dome-94/smart-weather-station-iot/docs/links.md

# 🔗 Project Media & External Resources

This document contains external cloud resources, presentation slides, and demonstration video links for the **Smart Weather Station IoT (IOT102 Final Project)**.

---

## 🎥 Video Demonstration
- **Demonstration Video (Google Drive)**: [Watch System Demo Video](https://drive.google.com/file/d/11cMH0WwSyZTcYttvgiP_zKkVfedbLLi1/view?usp=sharing)
- **Scope**: Demonstrates end-to-end hardware sensor telemetry over LoRa P2P 433MHz, ESP8266 Gateway dual-mode WiFi/Captive Portal, ThingSpeak IoT cloud synchronization, automated Python ML weather forecasting via GitHub Actions, and real-time Web Dashboard alerts.

---

## 📑 Presentation Slides & Academic Audit Records
- **Course Artifacts Folder (Google Drive)**: [Open Presentation & Audit Log Folder](https://drive.google.com/drive/folders/1S3p0Ww-17E4YuMg9cDz8nPTEcB69zPZF?usp=sharing)
- **Included Materials**:
  - Final Presentation Slides (`.pptx` / `.pdf`)
  - AI Usage Audit Logs & Academic Integrity Records
  - High-resolution hardware schematics and photos

---

## 📄 Final Academic Report
- The full final report is available directly in this repository: [Report_Group1_SE2036_SU26.pdf](Report_Group1_SE2036_SU26.pdf)
- Member Contribution breakdown: [Contribution.docx](Contribution.docx)
