dome-94/smart-weather-station-iot/docs/ai_audit_logs/Group1_AI_Auditlog_BangDCE205075.xlsx

Sheet: 1. Metadata & Summary
AI AUDIT LOG - METADATA & SUMMARY
STUDENT INFORMATION
Student Name: |  | Đào Chí Bằng
Student ID: |  | SE205075
Course: |  | IOT102
Assignment: |  | LoRa-Based Weather Station Monitoring System
AI USAGE SUMMARY
Total Prompts Used (all AI tools): |  | 50
Core Prompts Logged: |  | 8
Selection Ratio: |  | 16.0% |  | Should be 10-20%
Hallucination Detected: |  | [Count]
AI TOOLS USED
AI Tool | Purpose | Frequency | Main Value
Google Gemini | Assisting with baseline microcontroller programming, configuring hardware module communications, and optimizing IoT device performance. | High | Rapidly providing code templates for component control, debugging hardware connection issues, and suggesting power-saving solutions.
OpenAI ChatGPT | Researching wireless network architecture overview, designing data transmission payloads, and structuring the technical report outline. | High | Defining the optimal connectivity model for the system, standardizing data formats, and organizing documentation scientifically.
CORE PROMPTS DISTRIBUTION BY DTC COMPONENT
DTC Component | Number of Prompts | Required (Min)
Decomposition | 3 | ≥ 1
Pattern Recognition | 3 | ≥ 1
Abstraction | 3 | ≥ 1
Algorithms | 3 | ≥ 1

Sheet: 2. Detailed Audit Log
DETAILED AI AUDIT LOG
INSTRUCTIONS: Chỉ ghi CORE PROMPTS (Decision/Problem-Solving/Verification). Mỗi entry phải trả lời đầy đủ 4 câu hỏi trong Human Delta.
Entry # | Category | Stage/Component | Problem/Context | Prompt to AI | AI Response (Summary) | Human Delta & Reflection | Evidence
001 | Literature Review | System Architecture | The project requires a clear understanding of how a LoRa-based weather station monitoring system is typically designed. Before selecting hardware and software components, it was necessary to investigate common architectures used in academic and industrial implementations. | Explain the architecture of a LoRa-based weather station monitoring system and describe the role of sensors, ESP32, LoRa communication modules, gateways, cloud services, and monitoring dashboards. | The AI described a multi-layer architecture consisting of environmental sensors collecting weather data, ESP32 acting as the local controller, LoRa modules transmitting data over long distances, a gateway receiving packets, and cloud platforms visualizing information through dashboards. | The response provided a useful overview but remained generic. I reviewed several research papers and noticed that some implementations used LoRaWAN gateways while others used direct LoRa communication. Because the project scope is limited to a university prototype, implementing a complete LoRaWAN infrastructure would increase complexity without providing significant benefits. I therefore adapted the architecture by using direct LoRa communication between nodes and the receiver. The AI recommendation served as a starting point, but the final design decision was based on project constraints, budget considerations, and implementation feasibility. | Research papers, LoRa documentation, and project architecture diagram.
002 | Technology Comparison | Hardware Selection | The project required selecting a suitable microcontroller platform capable of handling sensor data acquisition, wireless communication, and future scalability. | Compare ESP32, ESP8266, and Arduino Uno for a LoRa-based weather monitoring project. Include processing power, memory, connectivity, and development flexibility. | The AI compared the three platforms and highlighted that ESP32 offers higher processing capability, integrated Wi-Fi and Bluetooth, larger memory, and better support for IoT applications. | The AI's comparison was generally accurate, but I validated the specifications using official datasheets. Arduino Uno was eliminated because of limited memory and processing capability. ESP8266 was considered a possible alternative, but its reduced resources could create limitations when integrating additional features in future versions. ESP32 offered a better balance between performance and cost. After considering development flexibility and long-term scalability, I selected ESP32 as the primary controller. This decision was supported by both AI recommendations and technical documentation. | ESP32 datasheet, ESP8266 datasheet, Arduino Uno specifications.
003 | Communication Design | Network Communication | One of the most important decisions was determining whether LoRa or Wi-Fi should be used as the primary communication technology for environmental monitoring. | Compare LoRa and Wi-Fi for outdoor weather monitoring systems, focusing on communication range, power consumption, reliability, and deployment cost. | The AI explained that LoRa provides long-distance communication and lower power consumption, while Wi-Fi offers higher bandwidth but shorter coverage and greater energy usage. | The response aligned with my initial understanding but required verification. I compared the AI explanation with technical resources from LoRa Alliance and academic publications. The analysis confirmed that LoRa is more suitable for remote monitoring environments where communication distance is a major concern. Although Wi-Fi would simplify cloud integration, it would significantly reduce deployment flexibility in outdoor environments. Consequently, LoRa was selected as the primary communication method, while Wi-Fi was retained only for local dashboard access and testing purposes. This hybrid approach balanced reliability and accessibility. | LoRa Alliance documentation and related IoT communication studies.
004 | Dashboard Selection | Cloud & Visualization | The project needed a dashboard solution capable of displaying real-time weather information and historical trends. | Compare Blynk and ThingSpeak for weather station monitoring projects. Discuss visualization features, ease of setup, analytics, and educational use. | The AI explained that Blynk focuses on user-friendly mobile dashboards and real-time visualization, whereas ThingSpeak emphasizes data analytics and cloud-based processing. | The AI comparison was useful but lacked practical deployment considerations. I tested both platforms using sample sensor data. Blynk provided a more attractive interface and faster setup process, making it suitable for project demonstrations. ThingSpeak offered stronger analytical features but required additional configuration. Since the primary objective of this project is monitoring rather than advanced analytics, I selected Blynk as the main dashboard platform. This decision improved usability while still satisfying the project requirements. | Blynk documentation, ThingSpeak documentation, prototype testing results.
005 | Fault Tolerance | System Reliability | The system should continue providing monitoring capabilities even when Internet connectivity becomes unavailable. | Suggest methods to maintain weather monitoring functionality during Internet outages in an ESP32 and LoRa-based system. | The AI recommended implementing local storage, buffering sensor data, and hosting a local web server on ESP32. | The recommendations were practical and directly relevant to the project. However, implementing all suggested features would exceed available development time. After evaluating complexity and benefits, I prioritized the Local Web Server approach because it allows users to access weather information directly within the local network. Data buffering was also considered for future improvements. The final design therefore includes offline visualization through a local web interface while maintaining cloud synchronization whenever connectivity is restored. | ESP32 Web Server implementation and project testing logs.
006 | Power Optimization | Energy Management | Weather stations are often deployed in remote areas where power efficiency is important. | How can ESP32 power consumption be minimized in a remote weather monitoring application? | The AI recommended Deep Sleep Mode, reduced transmission frequency, optimized sensor polling intervals, and disabling unused peripherals. | The response introduced several useful strategies. I further reviewed ESP32 power management documentation to understand implementation details. Deep Sleep Mode was identified as the most impactful optimization because the system only needs to collect data periodically rather than continuously. I modified the data collection cycle to wake the controller, gather measurements, transmit data, and return to sleep mode. This significantly reduced estimated power consumption and improved the feasibility of battery-powered operation. | ESP32 Power Management Documentation and prototype measurements.
007 | Cloud Integration | Gateway Node – ThingSpeak Cloud Storage | The existing weather station system only displayed real-time sensor data through the ESP8266 Local Web Server. No historical data was stored, making it difficult to analyze weather trends over long periods or generate charts for project reports. | How can I integrate ThingSpeak into the ESP8266 Gateway so that weather data received from LoRa can be stored in the cloud and visualized using historical charts? | The AI suggested creating a ThingSpeak channel, using the ESP8266 HTTPClient library, and sending temperature, humidity, pressure, and rain sensor data through HTTP requests. It also recommended mapping each sensor value to a ThingSpeak field for automatic storage and chart generation. | The AI provided a suitable approach for cloud integration but did not fully consider the current Gateway architecture. After reviewing the recommendation, I identified the need for Internet connectivity in addition to the existing Local Web Server. I adapted the implementation to support cloud synchronization while preserving local monitoring functions. I also added upload interval control and transmission error checking to ensure stable operation and compliance with ThingSpeak limitations. This enhancement allows long-term weather data storage and supports report preparation through automatically generated historical charts. | ThingSpeak channel configuration, ESP8266 HTTPClient implementation, modified Gateway source code, successful data uploads, and historical weather charts generated on the ThingSpeak platform.
008 | Frontend Development | Weather Dashboard UI/UX | The weather station project required a user-friendly dashboard for displaying real-time weather information received from the Gateway Node. The initial interface only showed raw values and lacked visual organization, making it difficult for users to quickly understand environmental conditions. | Create a modern HTML/CSS/JavaScript dashboard for an ESP8266 Local Web Server that displays temperature, humidity, pressure, rain status, system status, and a weather chart using a responsive design. | The AI generated a responsive weather dashboard using HTML, CSS, and JavaScript. The design included information cards, a large temperature display, status indicators, weather icons, and a Chart.js graph for visualizing temperature trends. The dashboard also used JavaScript fetch requests to retrieve real-time sensor data from the ESP8266 JSON API. | The AI-generated dashboard provided a good foundation but required optimization before deployment on the ESP8266 Local Web Server. I modified the layout, adjusted styling for better readability, integrated the existing JSON API structure, and ensured that weather data updated automatically without refreshing the page. Additional status indicators and chart visualization features were added to improve usability and presentation quality. The final dashboard achieved a professional appearance while remaining lightweight enough for embedded system deployment. | Dashboard HTML source code, CSS styling, JavaScript fetch implementation, real-time weather data display, Chart.js integration, and successful deployment on the ESP8266 Local Web Server.
009 | Firmware Logic Verification | ESP32 Sensor Node Workflow | The firmware workflow became more complex after integrating multiple sensors, LoRa communication, ACK verification, and Deep Sleep mode. Before final implementation, the team needed to verify that the execution sequence was logically correct and consistent with the system design. | Explain the execution workflow of an ESP32-based LoRa weather station firmware, including sensor initialization, data acquisition, packet transmission, ACK verification, retransmission, and Deep Sleep operation. | The AI described a complete firmware execution process beginning with system initialization, sensor reading, LoRa packet transmission, acknowledgment handling, and power-saving through Deep Sleep Mode. | The explanation was helpful for understanding the overall workflow, but several implementation details were incomplete. The AI omitted the retry limit, RTC memory update, and CRC verification sequence used in our project. I compared the explanation with the actual firmware and modified the workflow to accurately represent the implemented logic. The final flowchart was validated during system testing and included in the project documentation. | Firmware source code, system flowchart, implementation notes.
010 | System Testing | System Validation | Before the final demonstration, the complete weather monitoring system had to be validated to ensure reliable communication between sensors, LoRa nodes, the gateway, cloud services, and the dashboard. | Generate a testing checklist for a LoRa-based weather monitoring system, including sensor accuracy, wireless communication, cloud synchronization, dashboard visualization, and power management. | The AI generated a structured testing checklist covering hardware functionality, communication reliability, cloud connectivity, visualization accuracy, and system stability. | The generated checklist provided a useful starting point but did not include several project-specific scenarios such as LoRa retransmission testing, Deep Sleep recovery, and offline Local Web Server operation. I expanded the checklist based on actual testing activities performed during system validation to ensure all implemented features were verified before deployment. | System testing report, validation checklist, demonstration results.
011 | Presentation & Documentation | Technical Documentation | The project presentation required concise technical explanations describing the overall system architecture, firmware workflow, and communication process for the final demonstration. | Summarize the workflow of the LoRa weather monitoring system for presentation slides using concise and technically accurate language. | The AI produced a clear summary describing sensor data collection, LoRa communication, gateway processing, cloud synchronization, and dashboard visualization. | Although the explanation was well organized, it omitted several implementation details such as ACK validation, retransmission control, and offline monitoring through the Local Web Server. I revised the content using the actual firmware implementation and project architecture before including it in the presentation slides. | Final presentation slides, project documentation.
012 | Performance Optimization | Firmware Optimization | As the firmware became more complex with multiple sensors, LoRa communication, cloud synchronization, and power management, the team needed to improve system performance while maintaining reliability and reducing energy consumption. | Suggest optimization techniques for an ESP32-based LoRa weather monitoring system to improve performance, reduce memory usage, and minimize power consumption without affecting communication reliability. | The AI recommended optimizing sensor reading intervals, reducing unnecessary memory allocation, using Deep Sleep mode effectively, minimizing redundant data transmission, and improving code modularity for better maintainability. | Most recommendations were useful, but some optimization suggestions were not suitable for our implementation because they could reduce communication reliability. The team selectively applied appropriate improvements, including optimizing code structure, reducing unnecessary processing, and maintaining the existing ACK verification and retransmission mechanisms. The final firmware achieved better performance while preserving stable system operation. | Optimized firmware source code, testing results, power consumption comparison.

Sheet: 3. Hallucination Detection
HALLUCINATION DETECTION LOG (BẮT BUỘC)
MỖI PROJECT PHẢI PHÁT HIỆN ÍT NHẤT: Lab (≥1), Assignment (≥2), Project (≥3) cases hallucination
Entry # (from Sheet 2) | Hallucination Type | AI's Claim | Actual Fact | Detection Method | Correction Applied
001 | Technical Error | AI stated that ThingSpeak provides built-in real-time push notifications by default. | ThingSpeak primarily focuses on data collection, storage, visualization, and analytics. It does not provide native real-time push notification functionality in the same way as dedicated IoT dashboard platforms. | Verified the claim by reviewing the official ThingSpeak documentation and platform feature descriptions. | Removed the incorrect statement from the report and updated the platform comparison section to accurately describe ThingSpeak's capabilities.
002 | Incorrect Assumption | AI suggested that all ESP32 development boards include integrated LoRa communication modules. | Only specific ESP32 variants, such as ESP32 LoRa development boards, include built-in LoRa hardware. Standard ESP32 boards require an external LoRa module. | Verified hardware specifications using manufacturer datasheets and product documentation. | Revised the hardware selection section and clarified the distinction between standard ESP32 boards and LoRa-enabled variants.
003 | Sensor Misclassification | AI described the DHT22 sensor as a soil moisture sensor. | The DHT22 sensor is designed to measure ambient temperature and relative humidity. It cannot measure soil moisture levels. | Compared AI statement with LoRaWAN documentation and published experimental studies. | Updated the sensor description and corrected all references to sensor functionality within the project documentation.
004 | Overgeneralization | AI stated that all LoRa weather monitoring systems use cloud platforms such as ThingSpeak for data storage. | LoRa and Wi-Fi are designed for different purposes. LoRa offers long-range communication with low power consumption, while Wi-Fi provides higher bandwidth and faster data transmission. | Compared technical specifications, deployment scenarios, and performance characteristics from official documentation. | Added a balanced discussion explaining the strengths, limitations, and appropriate use cases of both technologies within the project report.
005 | Implementation Assumption | The generated dashboard code can be directly deployed to the ESP8266 Local Web Server without modification. | The generated code required adjustments to match the existing Gateway JSON API and optimize performance for the ESP8266 environment. | Reviewed the generated HTML/CSS/JavaScript code and tested it with the Gateway firmware. Several API endpoints and variable mappings were incompatible with the actual implementation. | Modified the JavaScript fetch requests, updated variable names according to the Gateway JSON structure, and optimized the dashboard to ensure stable operation on ESP8266.
006 | Context Ignorance | ThingSpeak integration can be added directly to the existing Gateway architecture without additional network configuration. | The existing Gateway was designed primarily as a Local Web Server using Wi-Fi Access Point mode. Internet connectivity and upload rate control were required before ThingSpeak integration could function correctly. | Compared the AI recommendation with the current Gateway firmware architecture and tested cloud communication requirements against ThingSpeak documentation. | Added Internet connectivity support, implemented upload interval control to comply with ThingSpeak limitations, and included error handling for failed data transmissions.
007 | Configuration Error | AI suggested that the ESP32 could upload sensor data directly to ThingSpeak without considering the gateway configuration or network architecture. | In our project, sensor data is transmitted via LoRa to the gateway, which processes the data before sending it to ThingSpeak using the correct API key and network connection. | Compared the AI-generated solution with the implemented gateway architecture and tested the actual cloud data transmission. | Modified the data flow to match the implemented architecture and configured the correct API endpoint, channel ID, and Write API Key before deployment.
HALLUCINATION TYPES REFERENCE:
Type | Definition | Example
Fabrication | AI tạo ra thông tin không tồn tại | Fake papers, fake APIs, fake data
Oversimplification | AI bỏ qua edge cases, exceptions | Code không handle array rỗng
Logic Error | AI đưa kết luận sai về 'best practice' | 'XGBoost always best' → Sai
Outdated Info | AI dùng thông tin cũ, không còn đúng | Old API syntax, deprecated methods
Context Misunderstanding | AI không hiểu đúng bối cảnh | Không biết business constraints

Sheet: 4. Self-Assessment Checklist
SELF-ASSESSMENT CHECKLIST (Trước khi nộp)
Kiểm tra kỹ trước khi nộp. MỖI ENTRY phải pass ≥4/5 tiêu chí dưới đây.
A. KIỂM TRA CHẤT LƯỢNG MỖI ENTRY (Pass ≥4/5)
# | Tiêu chí | Pass? | Note
1 | Prompt này ảnh hưởng đến quyết định quan trọng trong project? | ✅ | Clearly clarified the role of the prompt in shaping the core modules and optimizing the research progress.
2 | Nếu không có prompt này, project có thay đổi về architecture/design? | ✅ | Helped define and standardize the system architecture, preventing initial errors in circuit and algorithm design.
3 | Tôi có thể giải thích lý do chọn/không chọn gợi ý của AI? | ✅ | Thoroughly cross-referenced with system theory, retaining optimal solutions and filtering out impractical proposals.
4 | Có minh chứng cụ thể (code, metrics, comparison)? | ✅ | Fully supported by block diagrams, technical specifications from datasheets, and actual measurement data to validate results.
5 | Prompt này phản ánh tư duy phản biện, không chỉ copy AI? | ✅ | Demonstrated a continuous process of questioning, cross-checking reference materials, and self-correcting AI hallucinations.
B. KIỂM TRA TỔNG THỂ LOG
# | Tiêu chí | Pass? | Current Value
1 | Số lượng entries nằm trong range (min-max)? | ✅ | 10 entries
2 | Mỗi DTC component có ít nhất 1 core prompt? | Q | Each DTC component has at least one corresponding core prompt.
3 | Đã phát hiện ≥ số lượng hallucination yêu cầu? | ✅ | Hallucinations identified, verified, and corrected with reliable evidence.
4 | Mỗi entry đều có Human Delta đầy đủ (4 câu hỏi)? | ✅ | All 10 entries include complete Oral Viva preparation: why the prompt was used, AI limitations, team verification, and an alternative approach.
5 | Có evidence cho ≥70% entries? | ✅ | The ratio of actual concrete evidence meets the requirements, fully prepared for verification and cross-checkiEvidence is provided for all 10 entries, including source code, documentation, screenshots, test logs, and project records.ng.
⚠️ LƯU Ý QUAN TRỌNG:
Nếu entry KHÔNG pass ≥4/5 tiêu chí → LOẠI BỎ, không ghi vào Log
Nếu FAIL ≥2 tiêu chí tổng thể → AI Reflection = 0 điểm (mất 30%)
C. CHUẨN BỊ CHO ORAL VIVAS (Q&A)
Giảng viên sẽ hỏi ngẫu nhiên về 3-5 entries. Tự hỏi bản thân:
Entry # | Tôi có thể giải thích tại sao chọn approach này? | Tôi có nhớ AI response? | Tôi có evidence?
1 | Yes. I designed the Sensor Node flowchart to clearly describe the firmware execution from boot to Deep Sleep. | Yes. AI helped organize the workflow logically. | Yes. Final flowchart and project documentation.
2 | Yes. I included RTC memory, sensor validation, and Deep Sleep to improve reliability and power efficiency. | Yes. AI explained the ESP8266 execution flow. | Yes. Flowchart and firmware implementation.
3 | Yes. I added ACK verification, CRC-16 checking, and retry logic to improve LoRa communication reliability. | Yes. AI explained reliable communication concepts. | Yes. Flowchart, firmware logic, and communication tests.
4 | Yes. I Yes. I designed a responsive Local Dashboard to display weather information clearly on different devices.integrated ThingSpeak to store historical weather data and generate charts for long-term monitoring and reporting. | Yes. AI suggested the dashboard layout and UI improvements. | Yes. ThYes. HTML/CSS/JS source code and dashboard screenshots.ingSpeak configuration, upload logs, and generated historical charts.
5 | Yes. I used Chart.js and JSON APIs to visualize real-time weather data. | Yes. AI explained Chart.js and JavaScript fetch(). | Yes. Dashboard source code and testing results.
6 | Yes. I integrated the ESP8266 Local Web Server to provide real-time monitoring through Wi-Fi. | Yes. AI suggested the Web Server implementation. | Yes. ESP8266 source code and successful demonstrations.
7 | Yes. I integrated ThingSpeak to store historical weather data and generate cloud-based charts. | Yes. AI explained ThingSpeak API integration | Yes. ThingSpeak configuration, upload logs, and charts.
8 | Yes. I prepared the presentation slides to explain the system architecture, workflow, and implementation clearly. | Yes. AI suggested slide structure and content refinement. | Yes. Final presentation slides and project report.
9 | Yes. I prepared Oral Viva Q&A to explain design decisions, AI usage, limitations, and alternative solutions. | Yes. AI suggested possible Viva questions. | Yes. Oral Viva Q&A document and presentation notes.
10 | Yes. I reviewed and verified every AI-generated suggestion before applying it to the project. | Yes. AI was used only as a supporting tool; all outputs were manually verified. | Yes. AI Audit Log, code revisions, testing records, and project documents.
