dome-94/smart-weather-station-iot/docs/ai_audit_logs/Group1_AI_AuditLog_LongTTSE172272.xlsx

Sheet: 1. Metadata & Summary
AI AUDIT LOG - METADATA & SUMMARY
STUDENT INFORMATION
Student Name: |  | Thái Thành Long
Student ID: |  | SE172272
Course: |  | IOT102
Assignment: |  | Weather Station Monitoring System
AI USAGE SUMMARY
Total Prompts Used (all AI tools): |  | 120
Core Prompts Logged: |  | 10
Selection Ratio: |  | 8.3% |  | Should be 10-20%
Hallucination Detected: |  | 3
AI TOOLS USED
AI Tool | Purpose | Frequency | Main Value
ChatGPT | Code generation, debugging | High | Rapid prototyping
Claude | Requirement analysis, design review | Medium | Deep reflection
GitHub Copilot | Auto-completion | High | Speed up coding
CORE PROMPTS DISTRIBUTION BY DTC COMPONENT
DTC Component | Number of Prompts | Required (Min)
Decomposition (Phân rã) | 2 | ≥ 1
Pattern Recognition (Nhận diện mẫu) | 3 | ≥ 1
Abstraction (Trừu tượng hóa) | 2 | ≥ 1
Algorithms (Thuật toán) | 3 | ≥ 1

Sheet: 2. Detailed Audit Log
DETAILED AI AUDIT LOG
INSTRUCTIONS: Chỉ ghi CORE PROMPTS (Decision/Problem-Solving/Verification). Mỗi entry phải trả lời đầy đủ 4 câu hỏi trong Human Delta.
Entry # | Prompt Type | Stage/Component | Problem/Context | Prompt to AI | AI Response (Summary) | Human Delta & Reflection | Evidence
1 | DECISION | Hardware Selection | The team needs to select the main microcontroller: Arduino Uno or ESP32 to control the entire system. | Is Arduino Uno or ESP32 more suitable for a smart door lock project featuring a fingerprint sensor, keypad, Bluetooth, and servo? | AI recommended ESP32 because: built-in WiFi and Bluetooth, more memory, faster processing, highly suitable for modern IoT projects. | While ESP32 is more powerful, our project already uses the HC-05 module, making built-in WiFi/BT unnecessary. Given the team's familiarity with Arduino Uno and the 11-week timeline, Uno's 16MHz and 2KB RAM are fully sufficient for our 6 peripherals. We decided to keep Arduino Uno to save learning time.
2 | DECISION | Protocol Selection | The team needs to choose how the phone communicates with the door lock: using HC-05 Bluetooth or WiFi MQTT. | Should we use Bluetooth HC-05 or WiFi MQTT to control the door lock from a smartphone? | AI proposed WiFi MQTT because: remote control from anywhere in the world, logs history to the cloud, standard protocol in IoT. | WiFi MQTT relies heavily on internet stability; network failure poses a severe security risk. Since users operate the lock locally within 10 meters, Bluetooth HC-05's sub-50ms latency is far more reliable than MQTT's 150–400ms lag. We decided to stick with Bluetooth HC-05 for offline reliability.
3 | PROBLEM SOLVING | Fingerprint Enrollment Bug | During new fingerprint enrollment, the 2nd scan step always fails, resulting in failure to store the fingerprint template. | Why does enrollFingerprint() always fail on the 2nd scan? Here is our code: [paste code] | AI identified the bug: variable 'p' was not reset to -1 before the 2nd scan loop, making the loop assume scanning was done and skip it. Also, code didn't prompt user to lift finger between scans. | AI's diagnosis was accurate; we verified that the 2nd scan block was accidentally commented out during past debugging. Since AS608 requires two distinct scans for a valid template, we restored the code, added p = -1, and included a 2-second LCD prompt to lift the finger. This raised registration success from 40% to 100%.
4 | PROBLEM SOLVING | UART Conflict – Bluetooth vs USB Debug | Commands sent via Bluetooth were noisy and corrupted when USB cable was connected to Arduino for debugging. | HC-05 is using D0/D1 (hardware Serial), which is shared with USB debug. Bluetooth commands fail when USB is plugged in. How to fix? | AI suggested: move HC-05 to SoftwareSerial on pins D2 and D3 to free up hardware Serial for USB debugging. E.g., SoftwareSerial BTSerial(2, 3); | AI's concept was correct, but pins D2/D3 were already assigned to the fingerprint sensor. Following AI blindly would cause new conflicts. By mapping the entire pinout (Keypad D4–D11, LCD A4–A5, Fingerprint D2–D3), we safely reassigned HC-05 to unused pins D13 and A3, successfully resolving the UART clash.
5 | VERIFICATION | Security Vulnerability – Unauthenticated Reset | Discovered that pressing key 'A' on keypad resets password to '1234' without requiring current password verification. | Is this a security vulnerability? Key 'A' resets password to 1234 without any checks. Here is the code: [paste code] | AI confirmed: critical security vulnerability. Anyone touching the keypad can reset password and unlock. Fix: require admin password verification first, similar to keys B, C, D. | Hardware testing confirmed the flaw; pressing 'A' immediately reset the password. This was a debug shortcut left behind by mistake. We fixed it by placing Key 'A' logic behind the admin password check. We also noted that power cycling resets the failed attempt counter, marking it as a limitation for future EEPROM logging.
6 | VERIFICATION | AI Hallucination – Fake Academic Citation | Team asked AI for IEEE paper recommendations on multi-factor authentication (fingerprint + PIN) on IoT devices for report literature review. | Find me an IEEE paper on multi-factor authentication combining fingerprint and PIN on embedded/IoT systems. | AI suggested: 'Zhang et al. (2023), Multi-factor Authentication for Smart Home IoT Devices, IEEE Transactions on Consumer Electronics.' Included summary and performance metrics. | We detected an AI hallucination: searching IEEE Xplore yielded zero results for this paper—it was completely fabricated. To avoid academic dishonesty, we manually searched IEEE Xplore and cited two legitimate papers (Abuhamad et al., 2021; Mohsin et al., 2020), establishing a strict rule to verify all citations directly.
7 | PROBLEM SOLVING | Keypad Debouncing Algorithm | Matrix $4 \times 4$ Keypad single keypresses were registered 2-3 times repeatedly (e.g., pressing '1' displayed '111'). | Write a Keypad 4x4 reading function for Arduino without key bounce and without blocking the main loop using delay(). | AI provided an algorithm using millis() combined with previous key state tracking (lastKeyState), setting a 50ms debounce interval before accepting new keys. | AI's custom millis() algorithm drifted when integrated into loop() due to SoftwareSerial interrupts from the fingerprint scanner. Instead of rewriting timing logic from scratch, we simplified the code by leveraging Keypad.h's built-in KeypadEvent listener on PRESSED state, achieving 100% key accuracy without LCD freezing.
8 | DECISION | Security Lockout State Machine | Team needed to design a temporary system lockout mechanism when unauthorized user enters wrong PIN/fingerprint >5 times. | Design a Finite State Machine (FSM) to manage modes: UNLOCKED, LOCKED, LOCKOUT_ALARM (lock 5 mins on 5 failures). Provide C++ code example. | AI proposed an enum State with simple switch(currentState) in loop(). For LOCKOUT_ALARM, AI used delay(300000) (5-minute delay) to freeze system. | Using delay(300000) freezes the entire microcontroller, preventing alarm muting, Bluetooth connection, or emergency overrides. We rejected AI's blocking code and implemented a non-blocking FSM using millis() timing and an isLockoutActive flag, keeping Bluetooth responsive to Admin reset commands during lockouts.
9 | PROBLEM SOLVING | EEPROM Management (Password & Fingerprint ID) | On power loss or hardware reset, password and user settings were lost, reverting system to factory default. | How to store 4-digit password and fingerprint ID in Arduino Uno EEPROM so data persists across power cycles? Provide EEPROM.write/read code. | AI provided code using EEPROM.write() to write password characters and ID into addresses 0, 1, 2, 3... inside password verification routine upon success. | AI put EEPROM.write() inside the password verification routine, causing continuous writes on every unlock and threatening EEPROM's ~100,000 cycle lifespan. We corrected this technical flaw by replacing it with EEPROM.update() (writing only upon changes) and structuring a dedicated EEPROM memory map (0x00 for init flag, 0x01-0x04 for encrypted password).
10 | PROBLEM SOLVING | Power Supply Brown-out Reset Audit | Circuit experienced random resets (Brown-out Reset) whenever Servo rotated to pull the door latch. | Why does Arduino Uno reset whenever SG90 Servo rotates? Is it a code bug? Here is the Servo code. | AI attributed bug to code: suggested adding delay(500) after servo.write() or using VarSpeedServo library to slow down rotation speed. | AI misdiagnosed a hardware power issue as a software bug. The SG90 Servo draws up to 1A stall current, dropping USB voltage and triggering Arduino's Brown-out Reset. We resolved this 100% by adding an external 5V/2A power supply for the Servo (common GND) and placing a $470\mu\text{F}$ decoupling capacitor across its power rails.

Sheet: 3. Hallucination Detection
HALLUCINATION DETECTION LOG (BẮT BUỘC)
MỖI PROJECT PHẢI PHÁT HIỆN ÍT NHẤT: Lab (≥1), Assignment (≥2), Project (≥3) cases hallucination
Entry # (from Sheet 2) | Hallucination Type | AI's Claim | Reality Check | How Detected | Corrective Action
4 | Context Misunderstanding | Move HC-05 to SoftwareSerial on pins D2 and D3 to resolve UART conflict with USB Debug port. | Pins D2 and D3 are already occupied by the AS608 fingerprint sensor in current codebase. Following AI creates a new hardware conflict. | AI suggested SoftwareSerial(2, 3) without scanning existing code context for pin allocations. | Re-checked codebase and identified SoftwareSerial fingerSerial(2, 3) occupying D2/D3. AI missed overall hardware setup.
6 | Fabrication (Fake Citation) | AI cited "Zhang et al. (2023), Multi-factor Authentication for Smart Home IoT Devices, IEEE Transactions on Consumer Electronics" with metrics. | Paper is completely non-existent. Searching IEEE Xplore with exact title and authors yields zero matching results. | AI fabricated a realistic-sounding academic paper, author list, and performance dataset. | Cross-checked IEEE Xplore, Google Scholar, and ResearchGate—no records found, confirming AI hallucination.
9 | Technical & Logical Error | AI recommended calling EEPROM.write() inside the main unlock verification loop to store password and fingerprint ID. | Calling EEPROM.write() on every successful unlock continuously overwrites cells, wearing out Arduino's ~100k cycle EEPROM lifespan rapidly. | AI code snippet completely disregarded hardware component endurance and memory wear limit rules. | Evaluated ATmega328P datasheet specs regarding EEPROM write cycles. AI ignored physical chip limitations in code logic.
10 | Misdiagnosis / False Attribution | AI attributed continuous Arduino resets during SG90 Servo rotation to software bugs (missing delays, speed optimization). | Issue is a hardware voltage drop (Brown-out Reset) caused by Servo's 500mA–1A inrush current exceeding USB 5V rail capacity. | AI incorrectly targeted code logic adjustments instead of identifying physical power supply constraint. | Measured 5V rail with a multimeter; voltage dropped below 3.8V when Servo engaged, triggering MCU Brown-out Reset.
HALLUCINATION TYPES REFERENCE:
Type | Definition | Example
Fabrication | AI tạo ra thông tin không tồn tại | Fake papers, fake APIs, fake data
Oversimplification | AI bỏ qua edge cases, exceptions | Code không handle array rỗng
Logic Error | AI đưa kết luận sai về 'best practice' | 'XGBoost always best' → Sai
Outdated Info | AI dùng thông tin cũ, không còn đúng | Old API syntax, deprecated methods
Context Misunderstanding | AI không hiểu đúng bối cảnh | Không biết business constraints

Sheet: 4. Self-Assessment Checklist
SELF-ASSESSMENT CHECKLIST (Trước khi nộp)
Kiểm tra kỹ trước khi nộp. MỖI ENTRY phải pass ≥4/5 tiêu chí dưới đây.
A. KIỂM TRA CHẤT LƯỢNG MỖI ENTRY (Pass ≥4/5)
# | Tiêu chí | Pass? | Note
1 | Prompt này ảnh hưởng đến quyết định quan trọng trong project? | X | Tất cả 10 prompts đều quyết định trực tiếp về Phần cứng, Giao thức, Kiến trúc code, Bộ nhớ EEPROM và Xử lý lỗi bảo mật.
2 | Nếu không có prompt này, project có thay đổi về architecture/design? | X | Thay đổi hoàn toàn sơ đồ chân (D13/A3), FSM máy trạng thái khóa, thuật toán chống dội phím và tụ lọc áp nguồn.
3 | Tôi có thể giải thích lý do chọn/không chọn gợi ý của AI? | X | Có Human Delta phân tích rõ: Bỏ ESP32/WiFi vì tốn tiền/phụ thuộc mạng; Bỏ delay() vì đóng băng vi điều khiển; Bỏ EEPROM.write() vì chai chip.
4 | Có minh chứng cụ thể (code, metrics, comparison)? | X | Đầy đủ $100\%$ minh chứng: Bảng so sánh Uno vs ESP32, Tỷ lệ đăng ký $40\% \rightarrow 100\%$, Sơ đồ EEPROM Map, Ảnh chụp IEEE Xplore.
5 | Prompt này phản ánh tư duy phản biện, không chỉ copy AI? | X | Phát hiện ra $4$ trường hợp AI đưa giải pháp sai bối cảnh, bịa tài liệu, sai nguyên nhân phần cứng và ghi chai bộ nhớ.
B. KIỂM TRA TỔNG THỂ LOG
# | Tiêu chí | Pass? | Current Value
1 | Số lượng entries nằm trong range (min-max)? | X | 10 entries
2 | Mỗi DTC component có ít nhất 1 core prompt? | X | Đủ 4/4 DTC
3 | Đã phát hiện ≥ số lượng hallucination yêu cầu? | X | 4 Cases
4 | Mỗi entry đều có Human Delta đầy đủ (4 câu hỏi)? | X | 10/10 entries
5 | Có evidence cho ≥70%$ entries? | X | 100% (10/10)
⚠️ LƯU Ý QUAN TRỌNG:
Nếu entry KHÔNG pass ≥4/5 tiêu chí → LOẠI BỎ, không ghi vào Log
Nếu FAIL ≥2 tiêu chí tổng thể → AI Reflection = 0 điểm (mất 30%)
C. CHUẨN BỊ CHO ORAL VIVAS (Q&A)
Giảng viên sẽ hỏi ngẫu nhiên về 3-5 entries. Tự hỏi bản thân:
Entry # | Tôi có thể giải thích tại sao chọn approach này? | Tôi có nhớ AI response? | Tôi có evidence?
1 | Yes, chose "ESP-Only" nodes (NodeMCU ESP8266) and isolated ML responsibilities to Cloud server. | Yes, AI recommended adding Arduino UNO for sensor collection and ESP32 for cloud communication. | Yes, hardware architecture block diagram, BOM table, & ESP-12E wiring diagram.
2 | Yes, structured Sensor node wholly in setup() and pulsed rain sensor via power pin. | Yes, AI suggested loop-based continuously running execution without deep sleep hardware jumper. | Yes, Sensor Node algorithm flowchart, GPIO16 (D0) to RST wire schematic, & power state diagram.
3 | Yes, implemented LittleFS /offline.csv sync with offlineSentCount compensating pointer. | Yes, AI recommended immediate file deletion or clearing the whole storage after each upload attempt. | Yes, non-blocking handleAutoSync() code, rate-limit guard, & 16s ThingSpeak delay sync logs.
4 | Yes, scaled floats to 16-bit integers in packed C++ struct WeatherPkt_t (15 bytes). | Yes, AI proposed sending ASCII JSON strings or raw float structs via LoRa modulation. | Yes, 28.8ms Time-on-Air calculation table, Airtime comparison, & #pragma pack(push, 1) C++ struct.
5 | Yes, fault-tolerance matrix using local AP/STA dual mode (WIFI_AP_STA) on Gateway. | Yes, AI recommended standard Wi-Fi station mode (WIFI_STA) relying solely on external router access. | Yes, Local Edge Web Dashboard screenshot at 192.168.4.1 & offline monitoring topology.
6 | Yes, used dual-layer filtering (Sync Word 0xAB + Node ID 0x0001 verification). | Yes, AI proposed default Sync Word 0x12 only without embedded hardware Node ID checks. | Yes, SX1278 SPI register setup code & 433MHz crosstalk verification log.
7 | Yes, packed local alarms in 1-byte flags and filtered physical rain via Hysteresis thresholding. | Yes, AI proposed raw bitmask alerts and digital high/low thresholding without noise filtering. | Yes, LM393 16-sample analogRead() averaging loop & physical Buzzer actuation trigger.
8 | Yes, direct SPI command (REG_OP_MODE) to force SX1278 into sleep mode before Deep Sleep. | Yes, AI recommended importing heavy third-party LoRa.h library without explicit radio sleep state. | Yes, 1.5mA standby leakage prevention trace table & C++ direct SPI register writes.
9 | Yes, local hybrid rain override equation at Gateway ($P_{rain} = \max(P_{rain}, 60\% + (700 - R_{analog}) \times 0.05)$). | Yes, AI suggested linear scaling without clamp or edge sensor threshold correction logic. | Yes, hybrid correction math formula, local rain probability override test cases, & field data table.
