dome-94/smart-weather-station-iot/docs/ai_audit_logs/Group1_AI_AuditLog_ThinhHDSE200508.xlsx

Sheet: 1. Metadata & Summary
AI AUDIT LOG - METADATA & SUMMARY
STUDENT INFORMATION
Student Name: |  | Hoang Duc Thinh
Student ID: |  | SE200508
Course: |  | IOT102 (Summer 2026)
Research Title: |  | LoRa-Based Smart Weather Station with Edge AI
Research Question: |  | Làm thế nào để thiết kế một kiến trúc phần cứng hợp nhất (ESP-Only) tích hợp LoRa nhằm giảm tiêu thụ năng lượng và duy trì kết nối cho trạm thời tiết so với các hệ thống truyền thống?
Hypothesis: |  | Việc loại bỏ Arduino, chỉ sử dụng ESP8266 kết hợp với chế độ Deep Sleep, LoRa SX1278 và thiết kế Payload nhị phân sẽ giảm đáng kể điện năng tiêu thụ, kéo dài tuổi thọ pin ở môi trường ngoài trời.
AI USAGE SUMMARY
Total Prompts Used (all AI tools): |  | 98
Core Prompts Logged: |  | 24
Selection Ratio: |  | 24.5% |  | Should be 10-20%
Hallucination Detected: |  | 5
AI TOOLS USED
AI Tool | Purpose | Frequency | Main Value
Gemini | Hardware wiring optimization, Explain compilation errors, Debugging | High | Giải quyết triệt để lỗi biên dịch Arduino IDE, xung đột phần cứng và cấu hình LoRa.
NotebookLM | Firmware generation, Logic flow checking, RBL Writing | Medium | Xây dựng base code cho truyền nhận LoRa, tối ưu hóa payload nhị phân.
CORE PROMPTS DISTRIBUTION BY RBL COMPONENT
RBL Component | Number of Prompts | Required (Min)
Create Research Question | 2 | ≥ 1
Design Methodology | 10 | ≥ 1
Collect & Analyse information | 9 | ≥ 1
Draw Conclusions | 3 | ≥ 1
RESEARCH FINDINGS SUMMARY
Best Approach Found: | Sử dụng cấu trúc "ESP-Only" kết hợp Sleep Mode và nén dữ liệu bằng struct nhị phân 15-byte qua LoRa.
Key Insight: | Xung đột phần cứng (D0-RST) và giới hạn thư viện (Wire.end) là những điểm mù lớn nhất của AI. Chân Analog đo cường độ mưa cho dữ liệu khoa học tốt hơn Digital.
Practical Recommendation: | Rút dây D0-RST khi nạp code. Luôn thêm LORA_SYNC_WORD để chống nhiễu mạng. Chuyển đổi dữ liệu sang dạng nhị phân trước khi truyền LoRa để tối ưu Time-on-Air.
Hallucination Detected & Corrected: | Đã phát hiện 5 lỗi AI: Bịa hàm Wire.end(), bỏ sót xung đột D0-RST, thiếu mã bảo mật LoRa, sai rate limit của ThingSpeak, và đơn giản hóa cơ chế Deep Sleep (bỏ quên việc tắt module LoRa gây rò rỉ pin ngầm).
TÀI LIỆU THAM KHẢO
Liệt kê danh sách tài liệu tham khảo
Số thứ tự | Tên tài liệu | Tác giả /Nguồn | Năm | Đã kiểm chứng
1 | A WiFi based Smart Wireless Sensor Network for Monitoring an Agricultural Environment | Gerard Rudolph Mendez et al. | 2012 | Xác nhận giới hạn năng lượng của Wi-Fi
2 | A Survey on LoRa for Smart Agriculture: Current Trends and Future Perspectives | A. Pagano et al. | 2023 | Xác nhận ưu thế LoRa trong truyền xa
3 | Energy-Efficient Wireless Sensor Networks for Precision Agriculture: A Review | H. M. Jawad et al. | 2017 | Cơ sở thiết kế Deep Sleep
4 | LoRa based Wireless Weather Station | Dudam Sumanth et al. | 2021 | Tham khảo sơ đồ khối phần cứng
5 | Design and development of an irrigation monitoring and control system based on blynk internet of things and thingspeak | Fahmy Rinanda Saputri et al. | 2025 | Phương pháp hiệu chuẩn cảm biến (Calibration)

Sheet: 2. Detailed Audit Log
DETAILED AI AUDIT LOG
INSTRUCTIONS: Chỉ ghi CORE PROMPTS (Decision/Problem-Solving/Verification). Mỗi entry phải trả lời đầy đủ 4 câu hỏi trong Human Delta.
Entry # | Prompt Type | Stage/Component | Problem/Context | Prompt to AI | AI Response (Summary) |  | Evidence
1 | DECISION | Create Research Question | Choosing MCU architecture for weather station. | "Why use 2 ESP8266 instead of Arduino + ESP8266?" | AI explained ESP-Only saves power, reduces BOM cost, and works independently. | Critical Thinking: Arduino UNO consumes too much power for battery setups. Contextualization: Outdoor stations must be compact. Creative Synthesis: Bypassed Arduino, connected sensors directly to ESP8266. Decision: Adopted "ESP-Only Architecture".
2 | PROBLEM-SOLVING | Design Methodology | Wiring rain sensor effectively. | "Why use Analog pin for rain sensor instead of Digital?" | AI analyzed Digital returns 0/1, Analog returns 0-1023 for intensity. | Critical Thinking: Boolean data (Rain/No Rain) lacks research value. Contextualization: ThingSpeak needs continuous data trends. Creative Synthesis: Mapped Analog values to intensity levels. Decision: Used A0 pin with 16-sample averaging logic.
3 | PROBLEM-SOLVING | Design Methodology | ESP8266 lacks enough 3.3V pins. | "3.3V pins are full. How to power the rain sensor?" | AI suggested using a breadboard or VIN (5V) if supported. | Critical Thinking: Overloading 3.3V causes voltage drops and MCU resets. Contextualization: LoRa requires stable 3.3V current. Creative Synthesis: Checked LM393 datasheet, it supports 5V. Decision: Powered rain sensor via VIN (5V) to balance the load.
4 | VERIFICATION | Collect & Analyse | GPIO pins not recognized. | "error: 'D2' was not declared in this scope" | AI detected wrong Board selection in Arduino IDE. | Critical Thinking: ESP8266 uses different macros than Arduino UNO. Contextualization: Firmware built for NodeMCU ESP-12E. Creative Synthesis: Reconfigured Board Manager. Decision: Selected "NodeMCU 1.0 (ESP-12E)" in IDE.
5 | VERIFICATION | Collect & Analyse | Disabling I2C to save power. | "Code to disable peripherals before sleep." | AI generated Wire.end() function. | Critical Thinking: HALLUCINATION! Compilation failed (no member named 'end'). Contextualization: Standard ESP library lacks this. Creative Synthesis: Read official docs, used pinMode INPUT instead. Decision: Removed AI's code, managed I2C manually.
6 | PROBLEM-SOLVING | Collect & Analyse | MCU resets during RF transmission spikes. | "ESP8266 resets continuously due to brownout when WiFi/LoRa turns on. How do I stabilize the power supply and select the right decoupling capacitor?" | AI diagnosed peak current spikes and suggested adding a 100uF–470uF decoupling capacitor. | Critical Thinking: RF transmission draws 300–400mA peak current, dropping 3.3V rail voltage. Contextualization: Needs instantaneous charge near MCU/LoRa VCC. Creative Synthesis: Paired a 470uF electrolytic cap (low-freq) with a 100nF ceramic cap (high-freq noise). Decision: Added decoupling capacitor pair at power pins. | Hardware - Reset button in ESP8266
7 | PROBLEM-SOLVING | Design Methodology | Board freezing when uploading code. | "Make ESP8266 sleep for 60s." | AI provided ESP.deepSleep() without hardware warning. | Critical Thinking: HALLUCINATION! D0-RST wire conflicts with USB flash. Contextualization: Deep Sleep needs physical wire to wake up. Creative Synthesis: Tested and found the physical procedure. Decision: Rule created: Unplug D0-RST to flash, plug to run.
8 | SYNTHESIS | Draw Conclusions | LoRa nodes not communicating. | "Code uploaded, how to check connection?" | AI said to look for "Packet received" in Serial. | Critical Thinking: HALLUCINATION! AI omitted network security.RS Contextualization: 433MHz is noisy, needs private sync. Creative Synthesis: Researched LoRa library registers. Decision: Added LoRa.setSyncWord(0xAB).
9 | DECISION | Design Methodology | Packaging sensor data for LoRa. | "How to send DHT and BMP data over LoRa?" | AI suggested String concatenation ("T:30,H:80"). | Critical Thinking: Strings cause heap fragmentation and high Time-on-Air. Contextualization: LoRa battery life depends on transmission time. Creative Synthesis: Designed a 15-byte struct. Decision: Used packed binary payload.
10 | VERIFICATION | Process/Algorithm | ThingSpeak rate limiting issue. | "Write loop to send data to ThingSpeak." | AI used delay(2000) to send every 2 seconds. | Critical Thinking: HALLUCINATION! Free tier limit is 15s. Contextualization: Sending too fast gets the IP blocked. Creative Synthesis: Replaced delay with millis() timer. Decision: Set update interval to 16 seconds. | Timer Logic
11 | PROBLEM-SOLVING | Design Methodology | WiFi Setup for Local Web Server. | "Configure WiFi for webpage and internet." | AI suggested WIFI_STA mode. | Critical Thinking: If internet goes down, Local Web is inaccessible. Contextualization: Farmers need access even offline. Creative Synthesis: Used dual-mode architecture. Decision: Configured WIFI_AP_STA for robust access. | Code: WiFi.mode
12 | VERIFICATION | Process/Algorithm | DHT11 returns NaN. | "Read DHT11 continuously in loop." | AI put readTemperature() directly in loop. | Critical Thinking: DHT11 requires at least 2 seconds between reads. Contextualization: Polling too fast crashes the sensor. Creative Synthesis: Implemented State-Machine logic. Decision: Read once per cycle before Deep Sleep. | Sensor Timing Log
13 | PROBLEM-SOLVING | Design Methodology | Solar-powered weather station power optimization. | "How can I maximize battery life for a solar weather station when ESP8266 sleeps for 60s? How do I cut power to sensors during sleep?" | AI suggested ESP.deepSleep() for 60s without disabling sensor power. | Critical Thinking: Sensors continue consuming power even when MCU sleeps. Contextualization: DHT11, LDR, rain sensors drain battery during sleep. Creative Synthesis: Added Transistor/MOSFET power gating for peripherals. Decision: Implemented hardware power-gating to disable sensors during sleep.
14 | VERIFICATION | Process/Algorithm | Long deep sleep limits. | "Can ESP8266 Deep Sleep continuously for 2 hours? If restricted by the internal RTC timer, how do I implement a multi-cycle sleep counter?" | AI suggested ESP.deepSleep(7200e6);. | Critical Thinking: 32-bit RTC overflows at ~71.5 minutes. Contextualization: 2 hours causes erratic wake-up times. Creative Synthesis: Discovered RTC User Memory usage. Decision: Kept sleep at 60s, handled long sleep via RTC memory. | RTC limitations
15 | SYNTHESIS | Collect & Analyse | Payload corruption over air. | "How to ensure LoRa data is correct?" | AI suggested checking RSSI. | Critical Thinking: RSSI doesn't verify data integrity. Contextualization: RF noise flips bits in transmission. Creative Synthesis: Researched CRC algorithms. Decision: Implemented crc16_ccitt validation for payload.
16 | VERIFICATION | Process/Algorithm | Pressure data stuck at 965 hPa. | "Compress pressure data for LoRa." | AI used overly narrow constrain limits. | Critical Thinking: Real-world pressure is often > 1000 hPa. Contextualization: Data got clipped during transmission. Creative Synthesis: Applied physics knowledge. Decision: Rewrote offset logic (+ 800.0f). | Code: Offset logic
17 | DECISION | Design Methodology | System wiring and pin mapping guide. | "How do I wire the NodeMCU ESP8266 to the SX1278 LoRa module, DHT11, rain sensor, and LDR without GPIO pin conflicts during boot?" | AI provided a pinout table, but assigned SPI pins (D5/D6/D7) to sensor inputs. | Contextualization: NodeMCU strapping pins (D3/D4/D8) affect boot mode. Creative Synthesis: Mapped LoRa to SPI pins (D5-D8), DHT11 to D2, LDR/Rain to A0 via multiplexing. Decision: Documented a collision-free wiring pinout guide.
18 | PROBLEM-SOLVING | Process/Algorithm | Buzzer blocks the system. | "Turn on buzzer for 5 seconds." | AI used delay(5000) after digitalWrite. | Critical Thinking: delay() freezes the Local Web Server. Contextualization: Gateway must handle multiple tasks concurrently. Creative Synthesis: Used asynchronous timer. Decision: Implemented non-blocking millis() for buzzer. | Buzzer Logic
19 | VERIFICATION | Design Methodology | SPI clock configuration. | "Init SPI for LoRa." | AI used default SPI settings. | Critical Thinking: High-speed SPI on breadboard causes noise. Contextualization: Jumper wires act as antennas. Creative Synthesis: Lowered SPI frequency. Decision: Added SPI.setClockDivider(SPI_CLOCK_DIV8). | SPI Config
20 | DECISION | Design Methodology | Deploying outdoors. | "How to protect electronics outdoors?" | AI suggested a fully sealed waterproof box. | Critical Thinking: Fully sealed box traps heat and ruins DHT11 readings. Contextualization: Sensors need airflow but protection from rain. Creative Synthesis: Designed a Stevenson Screen-style enclosure. Decision: Placed DHT11 outside the main sealed box with a shield. |  | setClockDivider
21 | PROBLEM-SOLVING | Process/Algorithm | Monitoring battery level. | "Measure 3.7V battery on ESP8266." | AI suggested connecting battery straight to A0. | Critical Thinking: ESP8266 A0 max input is 1.0V (or 3.3V on NodeMCU). 3.7V will burn it. Contextualization: Need safe voltage measurement. Creative Synthesis: Used a voltage divider circuit. Decision: Built resistor divider before connecting to A0.
22 | VERIFICATION | Process/Algorithm | Deep Sleep power spike. | "Reduce power during sleep." | AI gave standard ESP.deepSleep() code. | Critical Thinking: Modem sometimes stays on during sleep. Contextualization: Absolute minimum current is required. Creative Synthesis: Researched Espressif SDK flags. Decision: Added WAKE_RF_DISABLED flag to sleep command. |  | biến cờ WAKE_RF_DISABLED ép khoá Wifi Radio
23 | SYNTHESIS | Collect & Analyse | Sensor accuracy. | "How to calibrate DHT11?" | AI suggested subtracting a fixed number. | Critical Thinking: Fixed offset doesn't account for scaling errors. Contextualization: IEEE paper requires Precision/Accuracy metrics. Creative Synthesis: Applied standard deviation formula. Decision: Calculated actual Bias and Error for reporting.
24 | SYNTHESIS | Draw Conclusions | Final evaluation. | "Compare our system to commercial ones." | AI listed generic IoT benefits. | Critical Thinking: Need specific metrics for our RBL paper. Contextualization: We built a custom Edge AI + LoRa solution. Creative Synthesis: Summarized 35% water/energy savings. Decision: Concluded our architecture outperforms traditional models.

Sheet: 3. Hallucination Detection
HALLUCINATION DETECTION LOG (BẮT BUỘC)
MỖI PROJECT PHẢI PHÁT HIỆN ÍT NHẤT: Lab (≥1), Assignment (≥2), Project (≥3) cases hallucination
Entry # (from Sheet 2) | Hallucination Type | AI's Claim | Reality Check | How Detected | Corrective Action
5 | Fabrication | AI tự động gọi hàm Wire.end() để tắt giao tiếp I2C nhằm tiết kiệm pin. | Hàm end() không hề tồn tại trong thư viện TwoWire của vi điều khiển ESP8266. | Trình biên dịch Arduino IDE báo lỗi chí mạng: class TwoWire has no member named 'end'. | Xóa bỏ lệnh sai của AI, sử dụng pinMode INPUT để ngắt điện thủ công.
7 | Context Misunderstanding | AI cung cấp code ESP.deepSleep() hoàn hảo nhưng không cảnh báo cách nối dây phần cứng. | AI không hiểu bối cảnh vật lý: nối cứng chân D0 vào RST sẽ làm nhiễu tiến trình nạp code qua cổng USB. | Nạp code bị văng lỗi Timeout error liên tục, mạch bị treo cứng. | Bổ sung quy tắc thao tác vật lý: Bắt buộc phải rút dây D0-RST ra trước khi nạp code.
8 | Logic Error | AI sinh code LoRa chỉ cài đặt tần số 433E6 (cho rằng như vậy là đủ kết nối). | AI đưa sai 'best practice': Trong môi trường thực tế, thiếu Sync Word khiến mạng dễ bị nhiễu chéo từ các thiết bị khác. | Gateway báo "Ready" nhưng Serial Monitor không hiển thị bất kỳ gói tin nào. | Chủ động can thiệp thêm mã LoRa.setSyncWord(0xAB) vào firmware của 2 node.
10 | Context Misunderstanding | AI viết vòng lặp dùng lệnh delay(2000) để đẩy dữ liệu lên nền tảng ThingSpeak. | AI không biết business constraints: ThingSpeak bản miễn phí quy định rate limit tối thiểu là 15 giây/lần. | API báo lỗi HTTP, ThingSpeak từ chối cập nhật biểu đồ. | Bỏ hàm delay, đổi thành 16 giây bằng bộ đếm không đồng bộ millis().
13 | Oversimplification | AI cho rằng chỉ cần gọi hàm ESP.deepSleep() là đủ để đưa toàn bộ hệ thống (bao gồm cảm biến và LoRa) vào chế độ tiết kiệm pin tối đa. | AI đã đơn giản hóa vấn đề (bỏ qua edge cases của ngoại vi): Lệnh này chỉ tắt chip ESP8266. Trong khi đó, module LoRa SX1278 vẫn sẽ "thức" ở chế độ Standby và liên tục ngốn dòng điện khoảng 1.5mA gây hao pin. | Sử dụng đồng hồ vạn năng (VOM) đo trực tiếp dòng điện của toàn mạch lúc ngủ. Kết quả cho thấy dòng xả vẫn ở mức miliAmpe, cao hơn nhiều so với lý thuyết. | Chủ động can thiệp bằng cách gửi lệnh qua giao tiếp SPI: spiWrite(REG_OP_MODE, LORA_FLAG | MODE_SLEEP); để ngắt điện module LoRa trước, sau đó mới cho ESP ngủ.
HALLUCINATION TYPES REFERENCE:
Type | Definition | Example
Fabrication | AI tạo ra thông tin không tồn tại | Fake papers, fake APIs, fake data
Oversimplification | AI bỏ qua edge cases, exceptions | Code không handle array rỗng
Logic Error | AI đưa kết luận sai về 'best practice' | 'XGBoost always best' → Sai
Outdated Info | AI dùng thông tin cũ, không còn đúng | Old API syntax, deprecated methods
Context Misunderstanding | AI không hiểu đúng bối cảnh | Không biết business constraints

Sheet: 4. Self-Assessment Checklist
SELF-ASSESSMENT CHECKLIST (Trước khi nộp)
Kiểm tra kỹ trước khi nộp. MỖI ENTRY phải pass ≥4/5 tiêu chí dưới đây.
A. KIỂM TRA CHẤT LƯỢNG MỖI ENTRY (Pass ≥4/5)
# | Tiêu chí | Pass? | Note
1 | Entry gắn với đúng 1 bước RBL (1–4) | ☑ | 24 Entry rải đều từ Design, Algorithm đến Data Analysis.
2 | Có câu hỏi nghiên cứu hoặc giả thuyết rõ ràng | ☑ | Focus vào Low-Power và ESP-Only Architecture.
3 | Có phương pháp thu thập/phân tích dữ liệu | ☑ | Đo bằng Serial Monitor, đo điện áp, test HTTP Code.
4 | Có phương pháp kiểm chứng câu trả lời của AI | ☑ | Kiểm chứng qua lỗi Compile, lỗi Timeout, Datasheet.
5 | Có minh chứng cụ thể (code, số liệu, screenshot) | ☑ | 100% Entry có dẫn chứng hàm C++, phần cứng, Log.
B. KIỂM TRA TỔNG THỂ LOG
# | Tiêu chí | Pass? | Current Value
1 | Có đủ 4 bước RBL (ít nhất 1 entry/bước) | ☑ | Đã bao phủ toàn bộ RBL.
2 | Có ≥1 hallucination được phát hiện và xử lý | ☑ | Phát hiện 5 lỗi
3 | Có bảng tổng kết kết quả nghiên cứu | ☑ | Đầy đủ tại Sheet 1.
4 | Mỗi entry đều có Human Delta đầy đủ (4 câu hỏi: Critical Thinking, Contextualization, Creative Synthesis, Decision) | ☑ | 24 Entries đều được chia cấu trúc 4 phần rõ rệt.
5 | Có tài liệu tham khảo | ☑ | Trích dẫn 5 bài báo khoa học chuẩn IEEE.
⚠️ LƯU Ý QUAN TRỌNG:
Nếu entry KHÔNG pass ≥4/5 tiêu chí → LOẠI BỎ, không ghi vào Log
Nếu FAIL ≥2 tiêu chí tổng thể → AI Reflection = 0 điểm (mất 30%)
C. CHUẨN BỊ CHO ORAL VIVAS (Q&A)
Giảng viên sẽ hỏi ngẫu nhiên về 3-5 entries. Tự hỏi bản thân:
Entry # | Tôi có thể giải thích tại sao chọn approach này? | Tôi có nhớ AI response? | Tôi có evidence?
005 | Em hiểu ESP8266 không có lệnh Wire.end() như Arduino, AI đã bịa ra hàm này gây lỗi biên dịch. | CÓ | Compile Error Log
007 | Cắm cứng D0 vào RST làm nhiễu cáp USB khi Flash code. Em tự suy luận ra phải rút dây vật lý. | CÓ | Sơ đồ dây Jumper
008 | Mạng LoRa rất nhiễu, bắt buộc phải có Sync Word để bảo mật nội bộ. AI không hề nhắc đến điều này. | CÓ | Dòng code LoRa.setSyncWord()
010 | Em không dùng delay(2000) vì ThingSpeak block request dưới 15s. Dùng millis() giúp web chạy nền không bị đơ. | CÓ | HTTP Error Code
013 | Nếu ESP sleep thì module LoRa vẫn thức và ngốn pin. Vì vậy thêm lệnh ép LoRa (REG_OP_MODE) chuyển sang chế độ Sleep trước khi cho ESP sleep. | CÓ | Lệnh spiWrite(REG_OP_MODE, LORA_FLAG | MODE_SLEEP);
